Remeny-Farm/esp32-photostation/hardware/case/stl/board_sled.stl

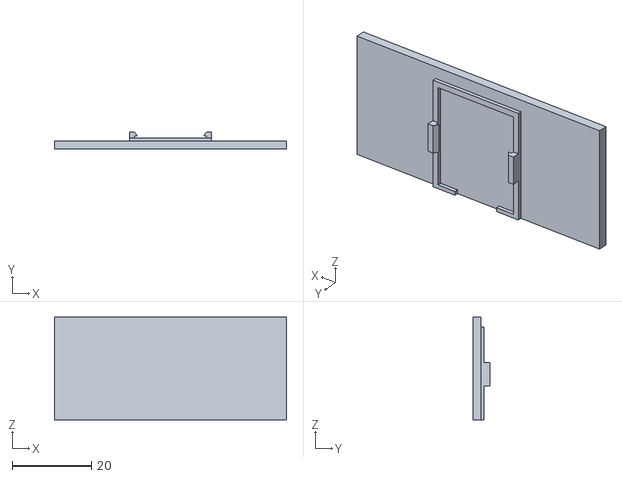
[picture p1: CAD file, 2026-11-07]
hardware/case/stl/board_sled.stl
58.6 x 4.35 x 26.0
