Remeny-Farm/esp32-photostation/hardware/case/stl/carriage.stl

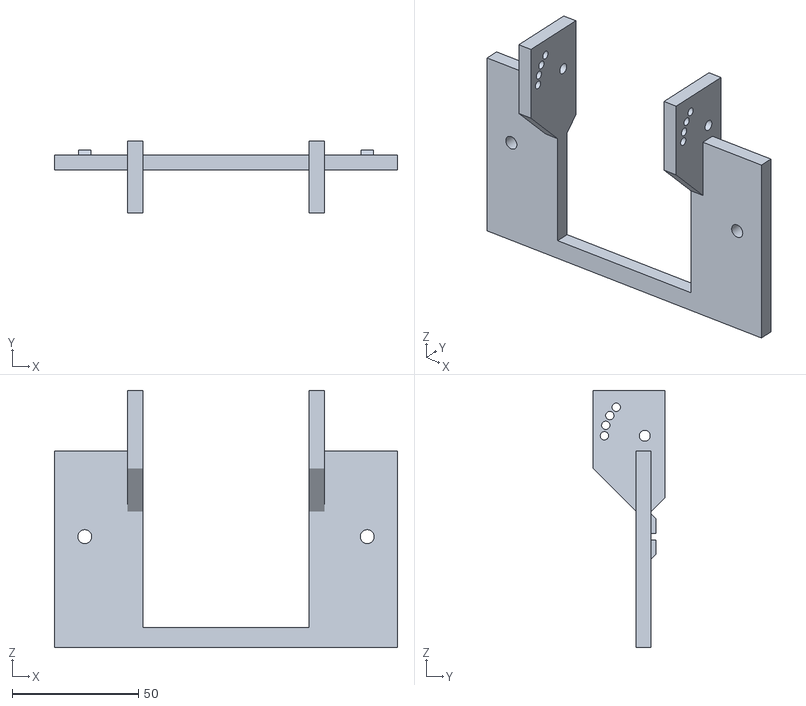
[picture p2: CAD file, 2026-11-07]
hardware/case/stl/carriage.stl
136.0 x 28.5 x 102.0
