Remeny-Farm/esp32-photostation/hardware/case/stl/antenna_holder.stl

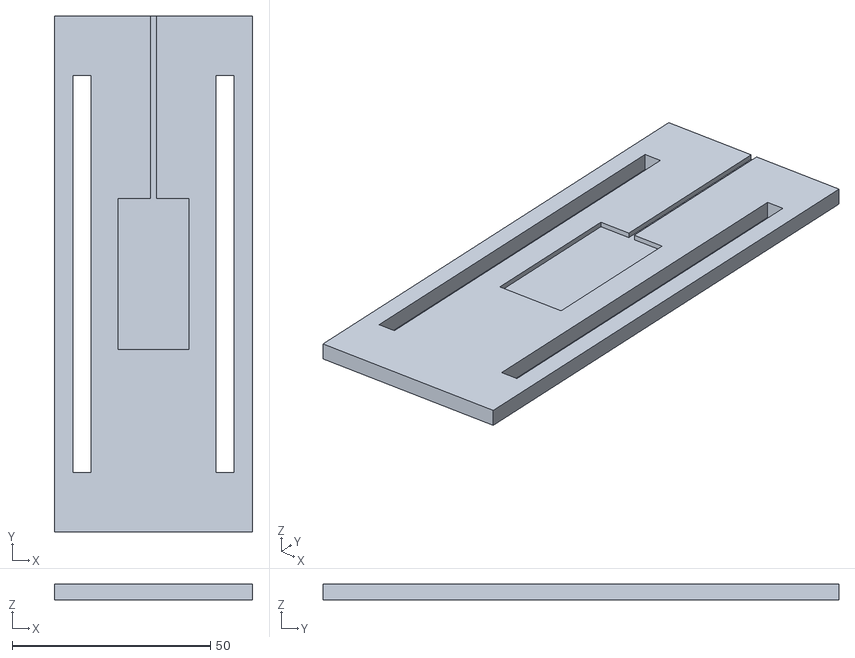
[picture p3: CAD file, 2026-11-07]
hardware/case/stl/antenna_holder.stl
50.0 x 130.0 x 4.00
