Remeny-Farm/esp32-photostation/hardware/case/stl/module_lid.stl

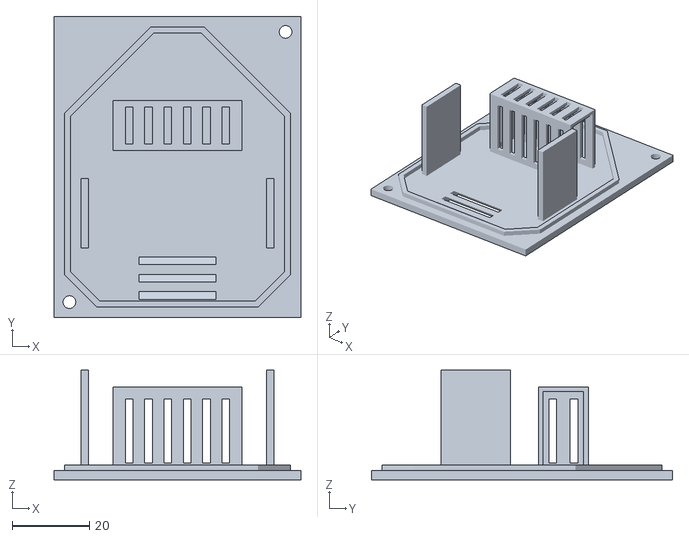
[picture p4: CAD file, 2026-11-07]
hardware/case/stl/module_lid.stl
64.0 x 78.0 x 28.4
