Remeny-Farm/esp32-photostation/hardware/case/stl/coupon_rail.stl

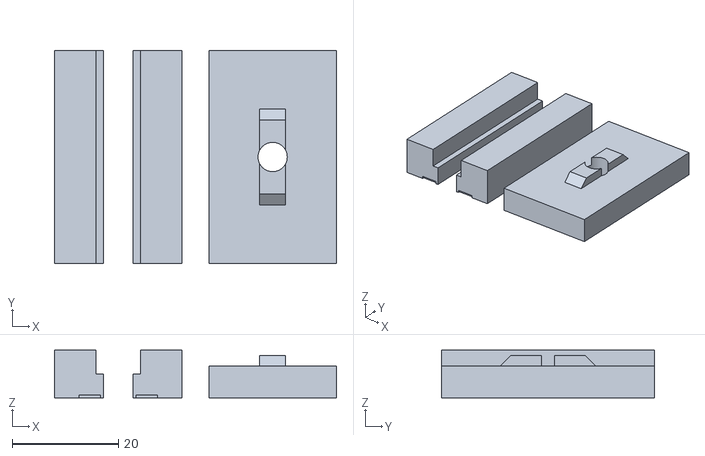
[picture p5: CAD file, 2026-11-07]
hardware/case/stl/coupon_rail.stl
53.0 x 40.0 x 9.00
