Remeny-Farm/esp32-photostation/hardware/case/stl/cable_clip.stl

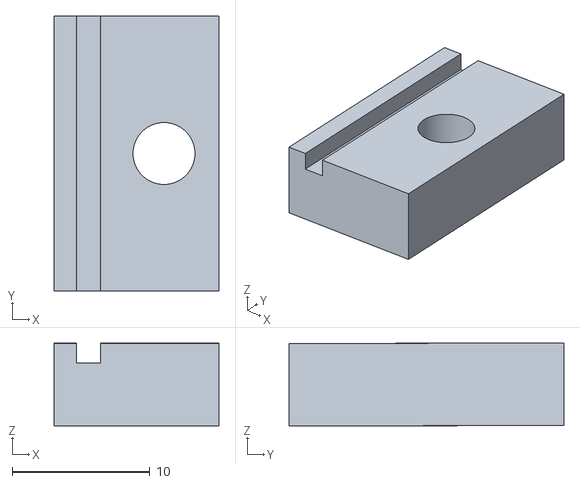
[picture p6: CAD file, 2026-11-07]
hardware/case/stl/cable_clip.stl
12.0 x 20.0 x 6.00
