Remeny-Farm/esp32-photostation/hardware/case/stl/bowl_holder.stl

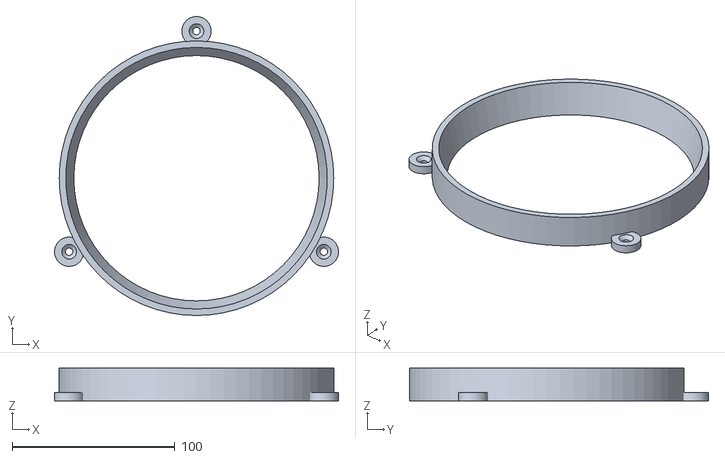
[picture p7: CAD file, 2026-11-07]
hardware/case/stl/bowl_holder.stl
174.4 x 183.6 x 20.0
