Remeny-Farm/esp32-photostation/hardware/case/stl/rail.stl

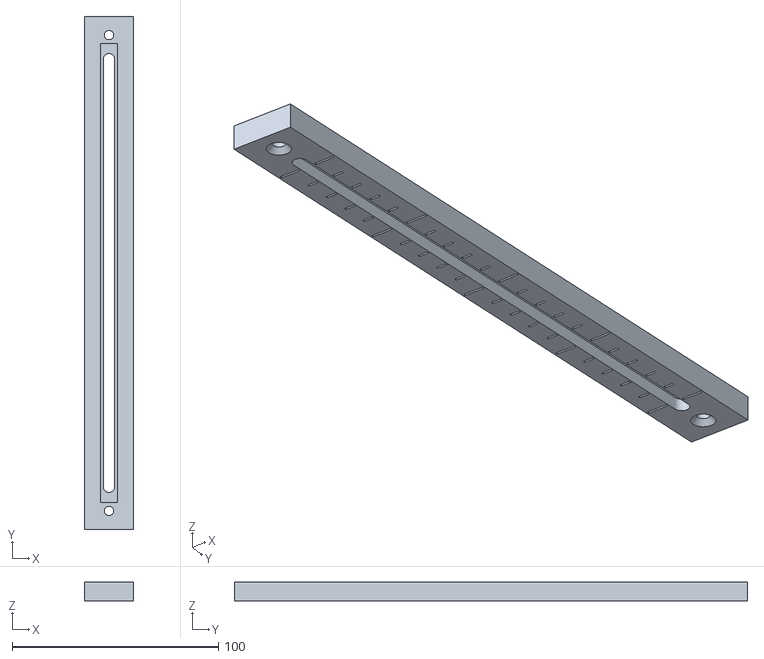
[picture p8: CAD file, 2026-11-07]
hardware/case/stl/rail.stl
24.0 x 249.0 x 9.00
