Remeny-Farm/esp32-photostation/hardware/case/stl/coupon_sled.stl

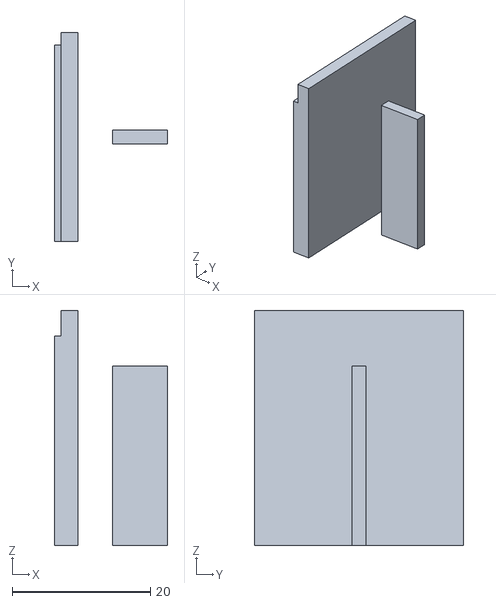
[picture p9: CAD file, 2026-11-07]
hardware/case/stl/coupon_sled.stl
16.4 x 30.2 x 34.0
