Remeny-Farm/esp32-photostation/hardware/case/stl/module_body.stl

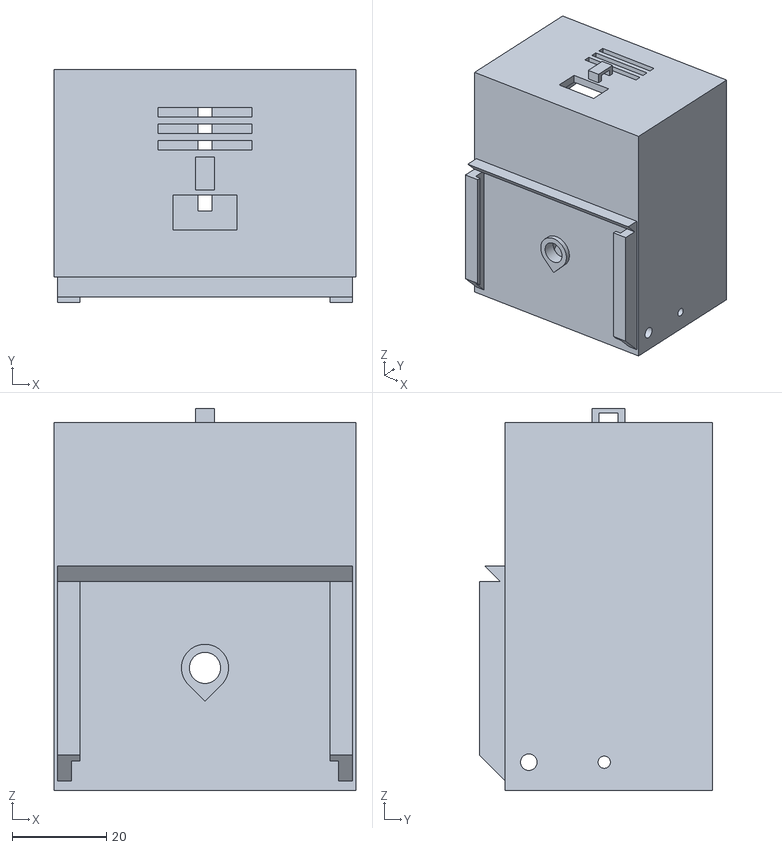
[picture p10: CAD file, 2026-11-07]
hardware/case/stl/module_body.stl
64.0 x 49.5 x 81.0
