Remeny-Farm/esp32-photostation/hardware/case/stl/window_frame.stl

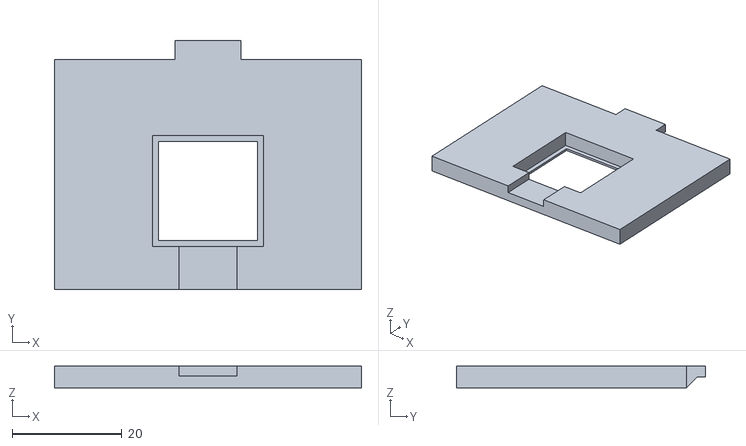
[picture p11: CAD file, 2026-11-07]
hardware/case/stl/window_frame.stl
56.0 x 45.5 x 4.00
