Remeny-Farm/esp32-photostation/hardware/case/stl/coupon_window.stl

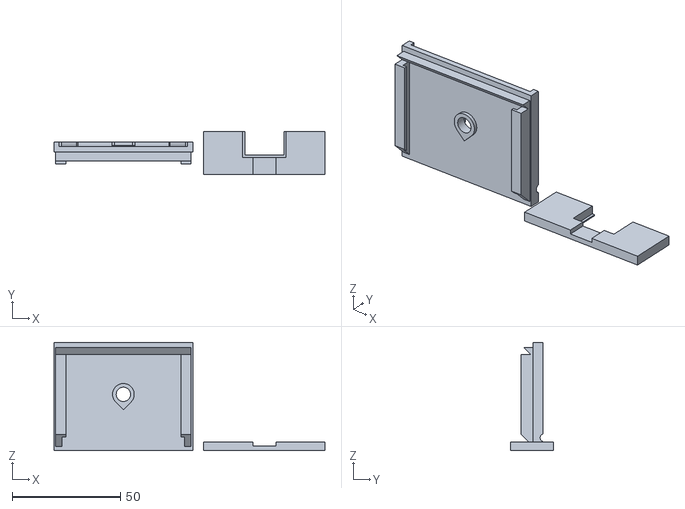
[picture p12: CAD file, 2026-11-07]
hardware/case/stl/coupon_window.stl
125.0 x 20.0 x 50.0
