Remeny-Farm/esp32-photostation/(list of files, cad)

Other CAD files:
hardware/case/station-case.blend
