Remeny-Farm/esp32-photostation/docs/superpowers/plans/2026-11-05-case-testbed.md

# Case test bed v1 Implementation Plan

> **For agentic workers:** REQUIRED SUB-SKILL: Use superpowers:subagent-driven-development (recommended) or superpowers:executing-plans to implement this plan task-by-task. Steps use checkbox (`- [ ]`) syntax for tracking.

**Goal:** A parametric Blender model of the v1 case test bed (printed camera module on a rail, plus the plywood corridor it mounts on), exported as printable STLs that slice cleanly on a Bambu P1S in PETG.

**Architecture:** All geometry is generated by Python scripts that run inside Blender 5.2 (headless for builds and checks, or through the Blender MCP for the live scene). One pure-Python `params.py` holds every dimension and the camera kinematics, so the numbers are unit-tested on the host without Blender. Each printable part is one module with `build(p) -> Object`; `assembly.py` places them with the corridor and component placeholders; `verify.py` checks fit, interference, field of view and metal clearance; `slice_check.py` slices every STL with the Bambu Studio CLI.

**Tech Stack:** Blender 5.2 `bpy`/`bmesh` (Boolean modifier, Manifold solver), Python 3 stdlib (`unittest`), Bambu Studio CLI (P1S 0.4 nozzle, 0.16 mm, PETG Basic).

**Spec:** `docs/superpowers/specs/2026-11-05-case-testbed-design.md` (English translation of the approved Hungarian design `2026-11-05-tok-tesztpad-design.md`).

## Global Constraints

- Units: millimetres everywhere; Blender scene Metric, unit scale 0.001, length mm.
- World frame: X across the corridor (0 = centre), Y along it (0 = inner face of the front wall, +Y towards the entrance), Z up (0 = top of the floor board).
- Printer: Bambu Lab P1S, 0.4 nozzle, bed 256 x 256; every part must fit 250 x 250 x 250 in its print orientation, lie on Z = 0, and print without supports.
- Material PETG; walls >= 2.4 mm (6 lines at 0.4); sliding fits 0.3 mm clearance per side, press fits 0.1 mm, unless `params.py` says otherwise.
- No metal (screws, nuts, foil) within 100 mm of the antenna radiator; the antenna holder uses M4 nylon bolts and wing nuts.
- Only BLE starts a visit: no PIR mount anywhere.
- English only in code, comments and docs (repo rule). No vendor CAD from `hardware/case/ref/` in the repo; placeholders use `DIMENSIONS.md` values.
- Generated files: `hardware/case/stl/<part>.stl`, `hardware/case/station-case.blend`; they are rebuilt by `build.py`, never edited by hand.
- Blender runs through `hardware/case/cad/blender.sh <script> [args]` (env `BLENDER` overrides the binary path); every local run is wrapped in `dev-budget run --kind heavy --`.

## Review Focus

1. Tilt at 45 deg in the top rail position: the module must not hit the wall, the carriage or the rail, and the window frame must still slide out upwards. Pinned by `verify.py` interference and frame-removal checks over all 12 states (Task 7).
2. A bowl of a different size: changing `bowl_d_base` must rebuild the holder and still fit the bed, or fail `check_part.py` with a clear message (Task 5).
3. Lens behind the wall plane: at no state may the lens or window be at Y >= -12 (wall outer face) minus 3 mm standoff (Task 1 test, Task 7 check).
4. Camera cable and USB plug: the board stack, camera, USB-C overmould and LED strips must sit inside the module without touching its walls (Task 7 placeholder-interference check).
5. Antenna cable length: the u.FL route from the module to the antenna must be computed, not assumed; the spec's 15-20 cm figure is checked against it and reported (Task 1 test, README BOM).

---

## Decided geometry (all in `params.py`)

Corridor (plywood, not printed): `t_wood = 12`, inner `250 W x 400 H x 650 L`, dead end at the front wall. Front-wall opening `open_w = 100` (X +-50), `open_z0 = 30`, `open_z1 = 355`.

Bowl and hen: `bowl_d_top = 180`, `bowl_d_base = 150`, `bowl_h = 60` (placeholders until measured), bowl centre `bowl_y = 185`. Head placeholder: sphere D50 at `(0, bowl_y, bowl_h + 40)`.

Module local frame: origin at the tilt pivot; `x` across, `y` forward (towards the wall), `z` up. Tilt is nose-down, positive degrees, steps `TILTS = (0, 15, 30, 45)`; world placement = rotate about X by `-tilt`, then translate to `(0, pivot_y, pivot_z)`.
- `pivot_y = -23.5` (world). Rail states `RAIL_PIVOT_Z = {"low": 125, "mid": 220, "high": 315}`.
- Module body box: `x +-32`, `y +2 .. -42`, `z +6 .. -72` (64 x 44 x 78), wall `2.4`.
- Lens front at local `(0, +1, -20)`; lens bore D6.6 with an inner 45 deg entry chamfer; shroud ring D10 OD standing `2.0` proud of the front face.
- Window frame: `56 W x 40 H x 4 D`, slides down into two guides on the body front from above; top at local `z = +4`; frame front face at local `y = +6` (world -17.5 at tilt 0). Clear 20 x 20 x 2 acrylic pane over the lens; the LED windows are 0.48 mm printed PETG skins (diffuser).
- LED pockets: two vertical `9 x 26 x 2.5` pockets in the body front at `x = +-18`, centred on the lens height.
- Board stack (XIAO + Sense, length axis vertical, u.FL end up, USB-C down): main PCB back at local `y = -14`, board spans `z -12 .. -33`; USB-C overmould `12.4 x 6.5 x 25` below it; camera module 8 x 8 behind the lens.
- Board sled: slides in from the rear along `-y` on side ribs; carries the board on its front face (`y -14`) and the AO3400 perfboard `20 x 30` on its rear face.
- Pivot: M4 self-tapping screw through each carriage cheek into a module side boss at local `(+-32, 0, 0)`; index: M3 self-tapping screw through one of four cheek holes into a module boss at radius 16 behind the pivot (`(+-32, -16, 0)` at tilt 0); cheek holes at `(-16 cos theta, +16 sin theta)` for theta in `TILTS`.
- Openings: bottom rectangular hole for the USB-C overmould (13.5 x 7.5, unplug before removing the sled), top slot 3 wide for the u.FL extension, open to the rear edge and closed by the lid. Bottom vent slots; lid vent slots under an outside hood. Silica gel pocket `30 x 20 x 10` on the lid inner face. Lid fixed by 2 x M3 self-tapping screws. A zip-tie anchor bar under the body bottom, behind the USB hole, is the strain relief; the drip loop hangs below it.

Rails (two, on the front-wall outer face): centre `x = +-56`, `24 W x 9 D`, Y -12 .. -21; hex-head channel on the wall side `8.4 W x 4.5 D` (stops the M5 hex head turning), slot `5.5` through the front skin; slot Z `81.5 .. 278.5`; total length <= 250 with a countersunk 4 mm wood-screw hole in each foot; 10 mm tick marks engraved on the front face. Printed front face down.

Carriage: a frame plate Y -21 .. -27, X +-68, Z `pivot -84 .. pivot +16`, with a hole for the module between two cheeks (X +-33 .. +-39, Y -17 .. -44, Z `pivot -8 .. +18`); one M5 bolt per rail at Z `pivot - 40`, wing nut on the -Y face; a 5 x 2 guide tongue on the rail-facing side runs in each rail slot.

Bowl holder: ring inner D `bowl_d_base + 2`, wall 4, height 20, three tabs with D4.5 holes. Antenna holder: plate `130 (Y) x 50 (X) x 4`, underside pocket `38 x 18 x 1.2` for the FPC radiator, coax groove, two `4.5 x 100` slots for M4 nylon bolts; default antenna centre world `(0, 300, 400)`. Cable clip: `20 x 12 x 6`, 2 mm coax channel, one D4.5 hole (x3).

### Revised in Task 1 (authoritative: `hardware/case/cad/params.py`)

The pivot hole needed 3 mm of wall ahead of it, so the module moved forward in its own frame: body `y +5 .. -39`, lens front `(0, +4, -20)`, main PCB back `y -11`, sled ribs `y -10.8 .. -13.2`, shroud 1.5 proud, cheeks `y +8 .. -20.5`. Where this section and the one above differ, this one wins.

Window frame and guides (shared by Task 3 and Task 4, exact):
- Frame: `x +-28`, `y +5 .. +9`, `z +4 .. -38`. Grip tab `x +-6`, `y +5 .. +7`, `z +4 .. +8`.
- Pane pocket, open to the back: `x +-10.1`, `z -20 +- 10.1`, `y +5 .. +8.5`; the pane sits at `y +6.5 .. +8.5` and touches the shroud top; front aperture `x +-9`, `z -20 +- 9`.
- LED windows: `x +-18 +- 4.5`, `z -20 +- 13`, cut from the back to `y = 9 - 0.48`.
- Guides on the body: `|x| 28.3 .. 31.3`, `y +5 .. +10.5`, `z -38.3 .. +4`; lip `|x| 26.5 .. 31.3`, `y +9.3 .. +10.5`; bottom stop `x +-31.3`, `y +5 .. +9.3`, `z -40.3 .. -38.3`. The guides end at `z +4`, not at the body top: at 45 deg tilt anything higher touches the wall.
- The frame slides out upwards at tilts 0 and 15; at 30 and 45 the operator first sets the tilt to 0 (one index screw).

### Revised in Task 7 (authoritative: `hardware/case/cad/params.py` and the part modules)

Where this section and the ones above differ, this one wins.

- Carriage tongue `tongue_len = 18`; rail slot Z `73.5 .. 286.5`; `rail_foot = 18` (rail length 249).
- Front-wall opening `open_w = 80`, `open_z1 = 375` (was 100 and 355): 16 mm of wood stays beside the rail screws, and the window frame lifts out at the high rail position at tilt 15.
- Window frame grip tab height `grip z = 3.5` (1 mm wall standoff at 45 deg).
- The carriage has no top bar: the module ties the cheeks together through the pivot screws. It prints upright, Z up, on its bottom bar.
- Print orientations: module body top face down (front face down cannot work, the guides stand proud); lid outer face down, with 45 deg louvres instead of an outside hood; board sled bottom edge down, plate upright.

### Revised after PR #4 (authoritative: `hardware/case/cad/params.py` and the part modules)

Where this section and the ones above differ, this one wins. PR #4 removed light control from the station: lighting is external and not part of the case. So the LED pockets, their backing pads and wire holes in the body, the LED windows and diffuser skins in the window frame, the AO3400 perfboard clips and seat on the board sled, and the `ph_perfboard`, `ph_led_l` and `ph_led_r` placeholders are removed, with their parameters and checks. The window frame is solid beside the pane; the sled's rear face is plain.

### Revised after the test-bed review (authoritative: `hardware/case/cad/params.py`, `assembly.py`, `verify.py`)

Where this section and the ones above differ, this one wins.

- The field check casts uncapped rays. Its obstacles are `wood_front`, the carriage, both rails and the module parts; the side walls, roof and floor are the scene. It also samples the crop boundary.
- The front-wall opening has a 45 deg bevel `open_bevel = 6.5` on the inner edges of its sides and bottom, so the central 60% is clear at the high rail position. It leaves 7.25 mm of wood beside each rail screw hole (check: at least 5).
- `rail_L` is the same print as `rail_R`, turned 180 deg about the world Y axis through the rail mid-height (it was a mirror image). The rail ticks are symmetric about the mid-height, on both sides of the slot.

---

### Task 1: Parameters, kinematics and Blender plumbing

**Files:**
- Create: `hardware/case/cad/params.py`, `hardware/case/cad/test_params.py`, `hardware/case/cad/mesh.py`, `hardware/case/cad/blender.sh`, `hardware/case/cad/check_part.py`, `hardware/case/cad/parts/__init__.py`
- Modify: `.github/workflows/ci.yml` (one step in `python-tests`)

**Interfaces:**
- Produces (`params.py`, no `bpy`): `P` frozen dataclass with the values above; `TILTS`, `RAIL_PIVOT_Z`; `lens_pose(p, pivot_z: float, tilt: float) -> tuple[Vec3, Vec3]` (lens world position, unit view direction); `local_to_world(p, pt: Vec3, pivot_z, tilt) -> Vec3`; `aim_tilt(p, pivot_z) -> float` (exact angle to the head); `nearest_tilt(angle) -> int` (from `TILTS`); `vfov_deg(p) -> float` (from 85 deg H, 4:3); `head_in_fov(p, pivot_z, tilt) -> bool` (whole head sphere inside the frustum); `antenna_cable_mm(p, pivot_z) -> float` (module top -> roof outside the wall -> roof hole -> antenna, +50 slack); `rail_length(p) -> float`.
- Produces (`mesh.py`, `bpy`): `box(name, size, center)`, `cyl(name, d, h, center, axis="Z", segments=64)`, `cone(name, d1, d2, h, center)`, `union(target, *others)`, `cut(target, *others)`, `intersect(target, other)` (all apply a Manifold Boolean modifier and delete the tools), `apply_print_rotation(obj, deg_xyz)` (rotates and drops min Z to 0), `export_stl(obj, path)`, `non_manifold_edges(obj) -> int`, `volume(obj) -> float`, `bbox(obj) -> (min, max)`, `reset_scene()`.
- Produces (`parts/__init__.py`): `PARTS = ["rail", "carriage", "module_body", "module_lid", "board_sled", "window_frame", "bowl_holder", "antenna_holder", "cable_clip"]` and `load(name)` (importlib). Each part module exposes `build(p) -> Object` (local/assembly frame), `PRINT_ROT: tuple[float, float, float]`, `COUNT: int`, optional `checks(obj, p) -> list[str]`.
- Produces (`check_part.py`): `blender.sh check_part.py <name>` builds the part, applies `PRINT_ROT`, and fails with exit 1 unless non-manifold edges = 0, volume > 0, bbox <= 2503 with min Z = 0, and `checks()` returns no errors.

- [ ] **Step 1: Write failing host tests** in `test_params.py`: `test_low_lens_is_level_with_head` (low, tilt 0: view dir == (0, 1, 0)); `test_distance_in_range` (for each state with `nearest_tilt(aim_tilt)`: 200 <= |head - lens| <= 300); `test_head_in_fov_all_states`; `test_lens_behind_wall` (all 12 states: lens y <= -12 - 3); `test_rail_fits_bed` (`rail_length <= 250`); `test_vfov` (68.5 < vfov < 69.5); `test_antenna_cable_reported` (`antenna_cable_mm(p, 315) > 200` - documents that the spec's 15-20 cm does not reach).
- [ ] **Step 2: Run** `cd hardware/case/cad && python3 -m unittest test_params -v` - expect import failure.
- [ ] **Step 3: Implement `params.py`** with the values in "Decided geometry".
- [ ] **Step 4: Run** the same command - expect all PASS.
- [ ] **Step 5: Implement `mesh.py`, `blender.sh`, `parts/__init__.py`, `check_part.py`**; prove the plumbing with a throwaway `cube` part: `dev-budget run --kind heavy -- hardware/case/cad/blender.sh check_part.py cube` -> `OK cube`, then delete it.
- [ ] **Step 6: Add the CI step** `python3 -m unittest discover -s hardware/case/cad -p 'test_*.py' -v` to `python-tests`.
- [ ] **Step 7: Commit** `feat(case): parameters, kinematics and Blender helpers for the test bed`.

### Task 2: Rail and carriage

**Files:** Create `hardware/case/cad/parts/rail.py`, `hardware/case/cad/parts/carriage.py`.

**Interfaces:** Consumes `P`, `mesh.*`. Produces `rail.build(p)` in world frame for the +X rail (assembly mirrors it; `COUNT = 2`, `PRINT_ROT` puts the front face on the bed); `carriage.build(p)` in module local frame (pivot at origin, `COUNT = 1`, `PRINT_ROT` puts the -Y face on the bed).

- [ ] **Step 1: Write `checks()`** for each: rail - slot width 5.5 +- 0.05 and channel 8.4 measured by ray casts at mid-length, length <= 250, two foot holes; carriage - cheek pivot holes D4.3 coaxial at `(+-36, 0, 0)`, four index holes per cheek at the `TILTS` arc, bolt holes D5.5 at `(+-56, *, -40)`.
- [ ] **Step 2: Run** `blender.sh check_part.py rail` and `carriage` - expect FAIL (no geometry).
- [ ] **Step 3: Implement** both builders from "Decided geometry".
- [ ] **Step 4: Run** both checks - expect `OK`.
- [ ] **Step 5:** Leave uncommitted; the parent commits after Task 7.

### Task 3: Module body, lid and board sled

**Files:** Create `hardware/case/cad/parts/module_body.py`, `module_lid.py`, `board_sled.py`.

**Interfaces:** Consumes `P`, `mesh.*`. All three in module local frame. Body `PRINT_ROT` puts the front face on the bed (lens bore, guides and LED pockets print without supports; rear open). Lid `PRINT_ROT`: outer face on the bed. Sled: rear face on the bed.

- [ ] **Step 1: Write `checks()`**: body - lens bore D6.6 on axis `(0, *, -20)`, pivot boss pilot D3.5 and index boss pilot D2.6 at both sides, USB hole 13.5 x 7.5, top slot open to the rear, sled ribs at `y -13.8 .. -16.2`; lid - two D3.3 holes matching body bosses, silica pocket >= 30 x 20 x 10; sled - board pocket 18.2 x 21.4, perfboard clips 20.4 apart, sled width fits the ribs with 0.3 clearance.
- [ ] **Step 2: Run** the three checks - expect FAIL.
- [ ] **Step 3: Implement** the three builders.
- [ ] **Step 4: Run** the three checks - expect `OK`.

### Task 4: Window frame

**Files:** Create `hardware/case/cad/parts/window_frame.py`.

**Interfaces:** Consumes `P`, `mesh.*`; guide geometry comes only from `P` (`frame_w`, `frame_h`, `frame_d`, `guide_*`), the same fields `module_body.py` uses. Module local frame. `PRINT_ROT`: front face on the bed, so the 0.48 mm diffuser skins are the first three layers.

- [ ] **Step 1: Write `checks()`**: pane pocket 20.2 x 20.2 x 2 opening to the back with a 0.5 retaining lip at the front, LED windows over `x = +-18` with skin thickness 0.48 +- 0.02, frame edges match the guides with 0.3 clearance.
- [ ] **Step 2-4:** check FAIL -> implement -> check `OK`.

### Task 5: Bowl holder, antenna holder, cable clip

**Files:** Create `hardware/case/cad/parts/bowl_holder.py`, `antenna_holder.py`, `cable_clip.py`.

**Interfaces:** Consumes `P`, `mesh.*`. Bowl holder in world frame centred at `(0, bowl_y, 0)`; antenna holder in world frame under the roof at the default antenna centre; clip `COUNT = 3`.

- [ ] **Step 1: Write `checks()`**: bowl holder inner D = `bowl_d_base + 2`, three D4.5 holes, and an explicit error message `"bowl holder exceeds the bed: split it"` when the footprint > 250; antenna holder pocket 38 x 18 x 1.2, two 4.5-wide slots 100 long; clip channel D2.
- [ ] **Step 2: Add a test** in `check_part.py`'s argument handling: `check_part.py bowl_holder --set bowl_d_base=260` must exit 1 with that message.
- [ ] **Step 3-5:** check FAIL -> implement -> checks `OK` (and the oversize case fails as specified).

### Task 6: Component placeholders and spec translation

**Files:** Create `hardware/case/cad/components.py`; create `docs/superpowers/specs/2026-11-05-case-testbed-design.md`.

**Interfaces:** `components.build_module_parts(p) -> list[Object]` in module local frame: XIAO stack (17.78 x 15 x 20.95 + USB-C receptacle), camera module 8 x 8 x 5.3 with lens D6.2, USB-C overmould 12.4 x 6.5 x 25 + cable D4.5, perfboard 20 x 30 x 1.6 + 8 mm component height, two LED strips 8 x 25 x 2. `components.build_world_parts(p) -> list[Object]`: bowl (truncated cone), head sphere, antenna FPC 37.4 x 17.5 x 1.8. All names prefixed `ph_`; all in a `placeholders` collection.

- [ ] **Step 1:** Implement; run `blender.sh components.py` - prints each placeholder with its bbox, exit 0.
- [ ] **Step 2:** Translate the Hungarian spec to English, same structure, status "approved by the owner 2026-11-05"; keep numbers verbatim.

### Task 7: Assembly, verification, coupons and build

**Files:** Create `hardware/case/cad/assembly.py`, `verify.py`, `coupon.py`, `build.py`. Generated: `hardware/case/stl/*.stl`, `hardware/case/station-case.blend`.

**Interfaces:** Consumes every earlier interface. `assembly.build(p, state="mid", tilt=None) -> dict[str, Object]` (wood boards with the opening, both rails, carriage, module parts, window frame, placeholders, one frustum per rail state at its `nearest_tilt`); `assembly.cut_list(p) -> list[tuple[str, int, float, float, float]]`. `coupon.build(p) -> dict[str, Object]`: `coupon_rail` (rail intersect a 40 mm slice + carriage tongue slice), `coupon_window` (body front strip intersect box + frame slice), `coupon_sled` (body rib section + sled edge).

- [ ] **Step 1: Write `verify.py` checks** (each prints `PASS/FAIL <name>`, exit 1 on any FAIL): every STL manifold and on the bed; for all 3 rail states x 4 tilts, Manifold intersection volume < 1 mm3 between module group, carriage, rails and wood; placeholders inside the module do not intersect module solids; head visible (sample rays lens -> head miss wood, bowl and module) at `nearest_tilt`; window frame swept +45 mm along the module up-axis hits nothing; every metal fastener >= 100 mm from the antenna FPC.
- [ ] **Step 2: Run** `blender.sh verify.py` - expect FAIL (no build yet).
- [ ] **Step 3: Implement** `assembly.py`, `coupon.py`, `build.py` (exports one STL per part and coupon, saves the `.blend` with the mid/30 deg state, prints the cut list).
- [ ] **Step 4: Run** `blender.sh build.py && blender.sh verify.py` - expect all PASS. A FAIL is fixed in `params.py` or the owning part, never by loosening the check.
- [ ] **Step 5: Commit** parts, scripts and generated files: `feat(case): printable test-bed parts and assembly checks`.

### Task 8: Slicer check, docs and live scene

**Files:** Create `hardware/case/cad/slice_check.py`. Modify `hardware/case/README.md`, `CHANGELOG.md`, `AGENTS.md` (repo map line for `hardware/case/cad/`).

- [ ] **Step 1: Implement `slice_check.py`** after `hen-tag-enclosure/cad/slice_check.py`: stdlib only, P1S 0.4 machine, `0.16mm Optimal @BBL X1C` process, `Bambu PETG Basic @BBL X1C`, slices every `stl/*.stl`, fails on `[error]`, `CRITICAL` or `floating cantilever`; skips with exit 0 when Bambu Studio is missing.
- [ ] **Step 2: Run** `dev-budget run --kind heavy -- python3 -I hardware/case/cad/slice_check.py` - expect `PASS` per part.
- [ ] **Step 3: Update `hardware/case/README.md`**: v1 test bed (no PIR), part list with counts and print orientation, print settings, BOM (screws, nylon M4, acrylic pane, u.FL extension with the computed length), wood cut list from `assembly.cut_list`, assembly steps, how to rebuild (`blender.sh build.py`), the caliper list from spec section 7.
- [ ] **Step 4: Add the CHANGELOG line** under `Unreleased / Added`.
- [ ] **Step 5: Load the scene in the live Blender** through the MCP (open `station-case.blend`), take `look` views (front, three-quarter, camera through each frustum) for the owner.
- [ ] **Step 6: Commit** `docs(case): print, assembly and slicing notes for the test bed`.
