Remeny-Farm/esp32-photostation/(commit log)

2026-11-05 Initial public release: esp32-photostation 0.3.0
    ESP32-S3 (Seeed XIAO ESP32S3 Sense) animal camera station: PIR-triggered
    photo bursts, BLE tag identification, offline SD queue and HTTPS upload to
    a configurable server.
2026-11-05 docs(case): add mechanical reference dimensions (#3)
    * docs(case): add mechanical reference dimensions
    Collect the part dimensions the enclosure must fit (XIAO ESP32S3 Sense
    stack, camera modules, FPC antenna, AM312 PIR, LED strip, microSD,
    USB-C plug), each with its source and confidence. Third-party datasheets
    and vendor CAD stay local and gitignored because their licenses do not
    clearly allow redistribution.
    * docs(case): state the real model frame and fix the microSD overhang
    * docs(case): mark the camera position as raw model data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
2026-11-05 feat(station)!: remove light control, lighting is external (#4)
    The station no longer drives a light. Lighting is an external, constant
    light on its own timer that is off at night. Removes the GPIO2 PWM
    driver, the light console command, the light= INFO field and the
    light_pwm visit JSON field; docs describe the external light and the
    dark-photo limitation at night.
    [station.ino]
2026-11-07 feat(case): v1 case test bed, parametric Blender model and STLs (#5)
    * feat(case): parameters, kinematics and Blender helpers for the test bed
    Plan and English design spec for the v1 test bed, plus the pure-Python
    parameter set with host tests and the headless Blender plumbing.
    * fix(case): move the pivot 5 mm behind the module front
    The pivot hole had 0.25 mm of wall ahead of it. Shift the module forward
    in its own frame and pin the shared window-frame and guide dimensions.
    * feat(case): printable test-bed parts and assembly checks
    Nine printable parts and three fit coupons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
    [antenna_holder.stl, board_sled.stl, bowl_holder.stl, cable_clip.stl, carriage.stl, coupon_rail.stl, coupon_sled.stl, coupon_window.stl]
